davidpalma666/OE-PyBoard-tester-Fork/abstract remake Filipe @17122025.jpg

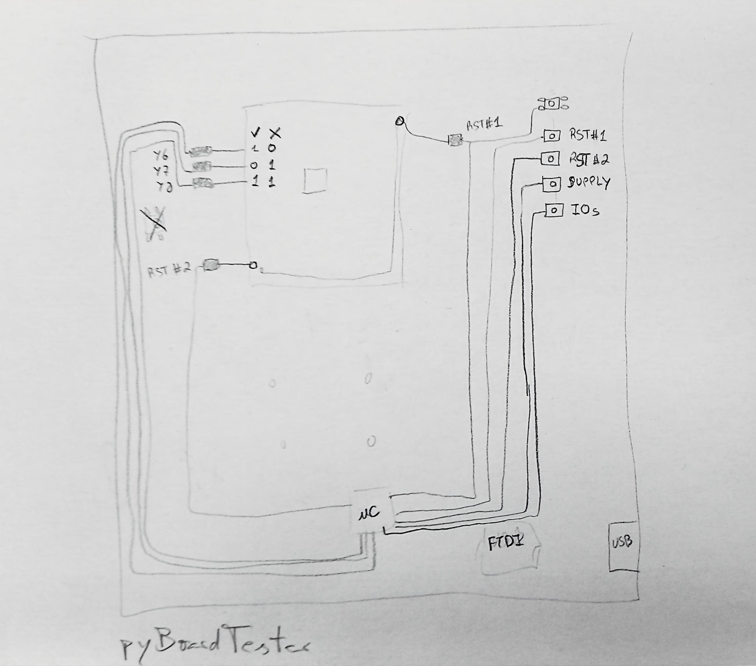
abstract remake Filipe @17122025.jpg
