davidpalma666/OE-PyBoard-tester-Fork/PCB/OE PyBoard tester FootprintLib/SW_SPST_TL3305B.step

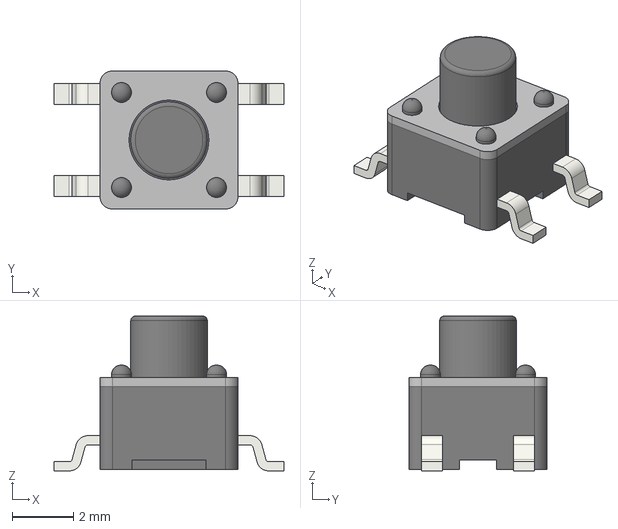
[picture p2: CAD file, 2026-01-06]
PCB/OE PyBoard tester FootprintLib/SW_SPST_TL3305B.step
7.50 x 4.50 x 5.05 mm
