davidpalma666/OE-PyBoard-tester-Fork/PCB/OE PyBoard tester FootprintLib/TSW-116-06-T-S.stp

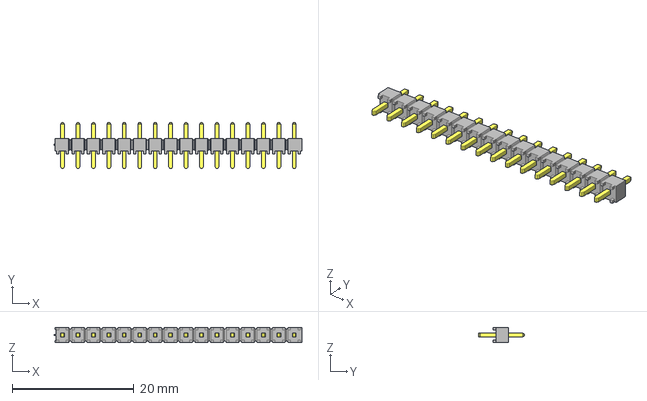
[picture p3: CAD file, 2026-01-06]
PCB/OE PyBoard tester FootprintLib/TSW-116-06-T-S.stp
40.8 x 7.62 x 2.54 mm
TSW-116-06-T-S_body
T-1S6-18-TSW-1-06-16-S
