davidpalma666/OE-PyBoard-tester-Fork/PCB/OE PyBoard tester FootprintLib/ECS-.327-12.5-17X-C-TR.step

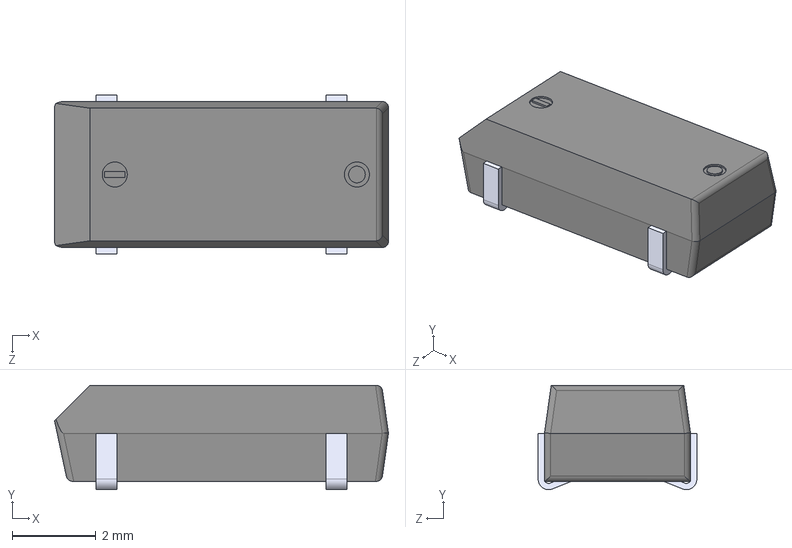
[picture p4: CAD file, 2026-01-06]
PCB/OE PyBoard tester FootprintLib/ECS-.327-12.5-17X-C-TR.step
8.00 x 2.50 x 3.80 mm
