davidpalma666/OE-PyBoard-tester-Fork/PCB/OE PyBoard tester FootprintLib/475710001.stp

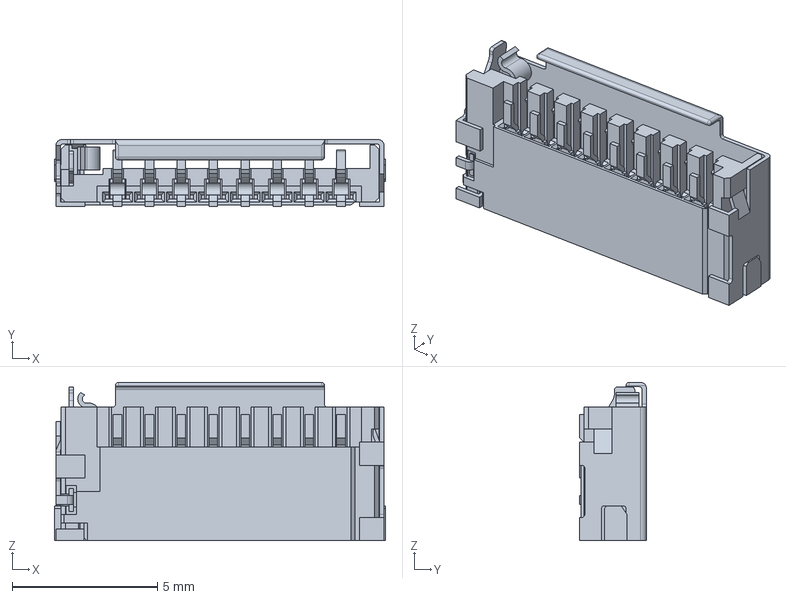
[picture p5: CAD file, 2026-01-06]
PCB/OE PyBoard tester FootprintLib/475710001.stp
11.4 x 2.30 x 5.45 mm
