davidpalma666/OE-PyBoard-tester-Fork/PCB/OE PyBoard tester.kicad_pcb

## KiCad design PCB/OE PyBoard tester.kicad_pcb (2026-01-22)

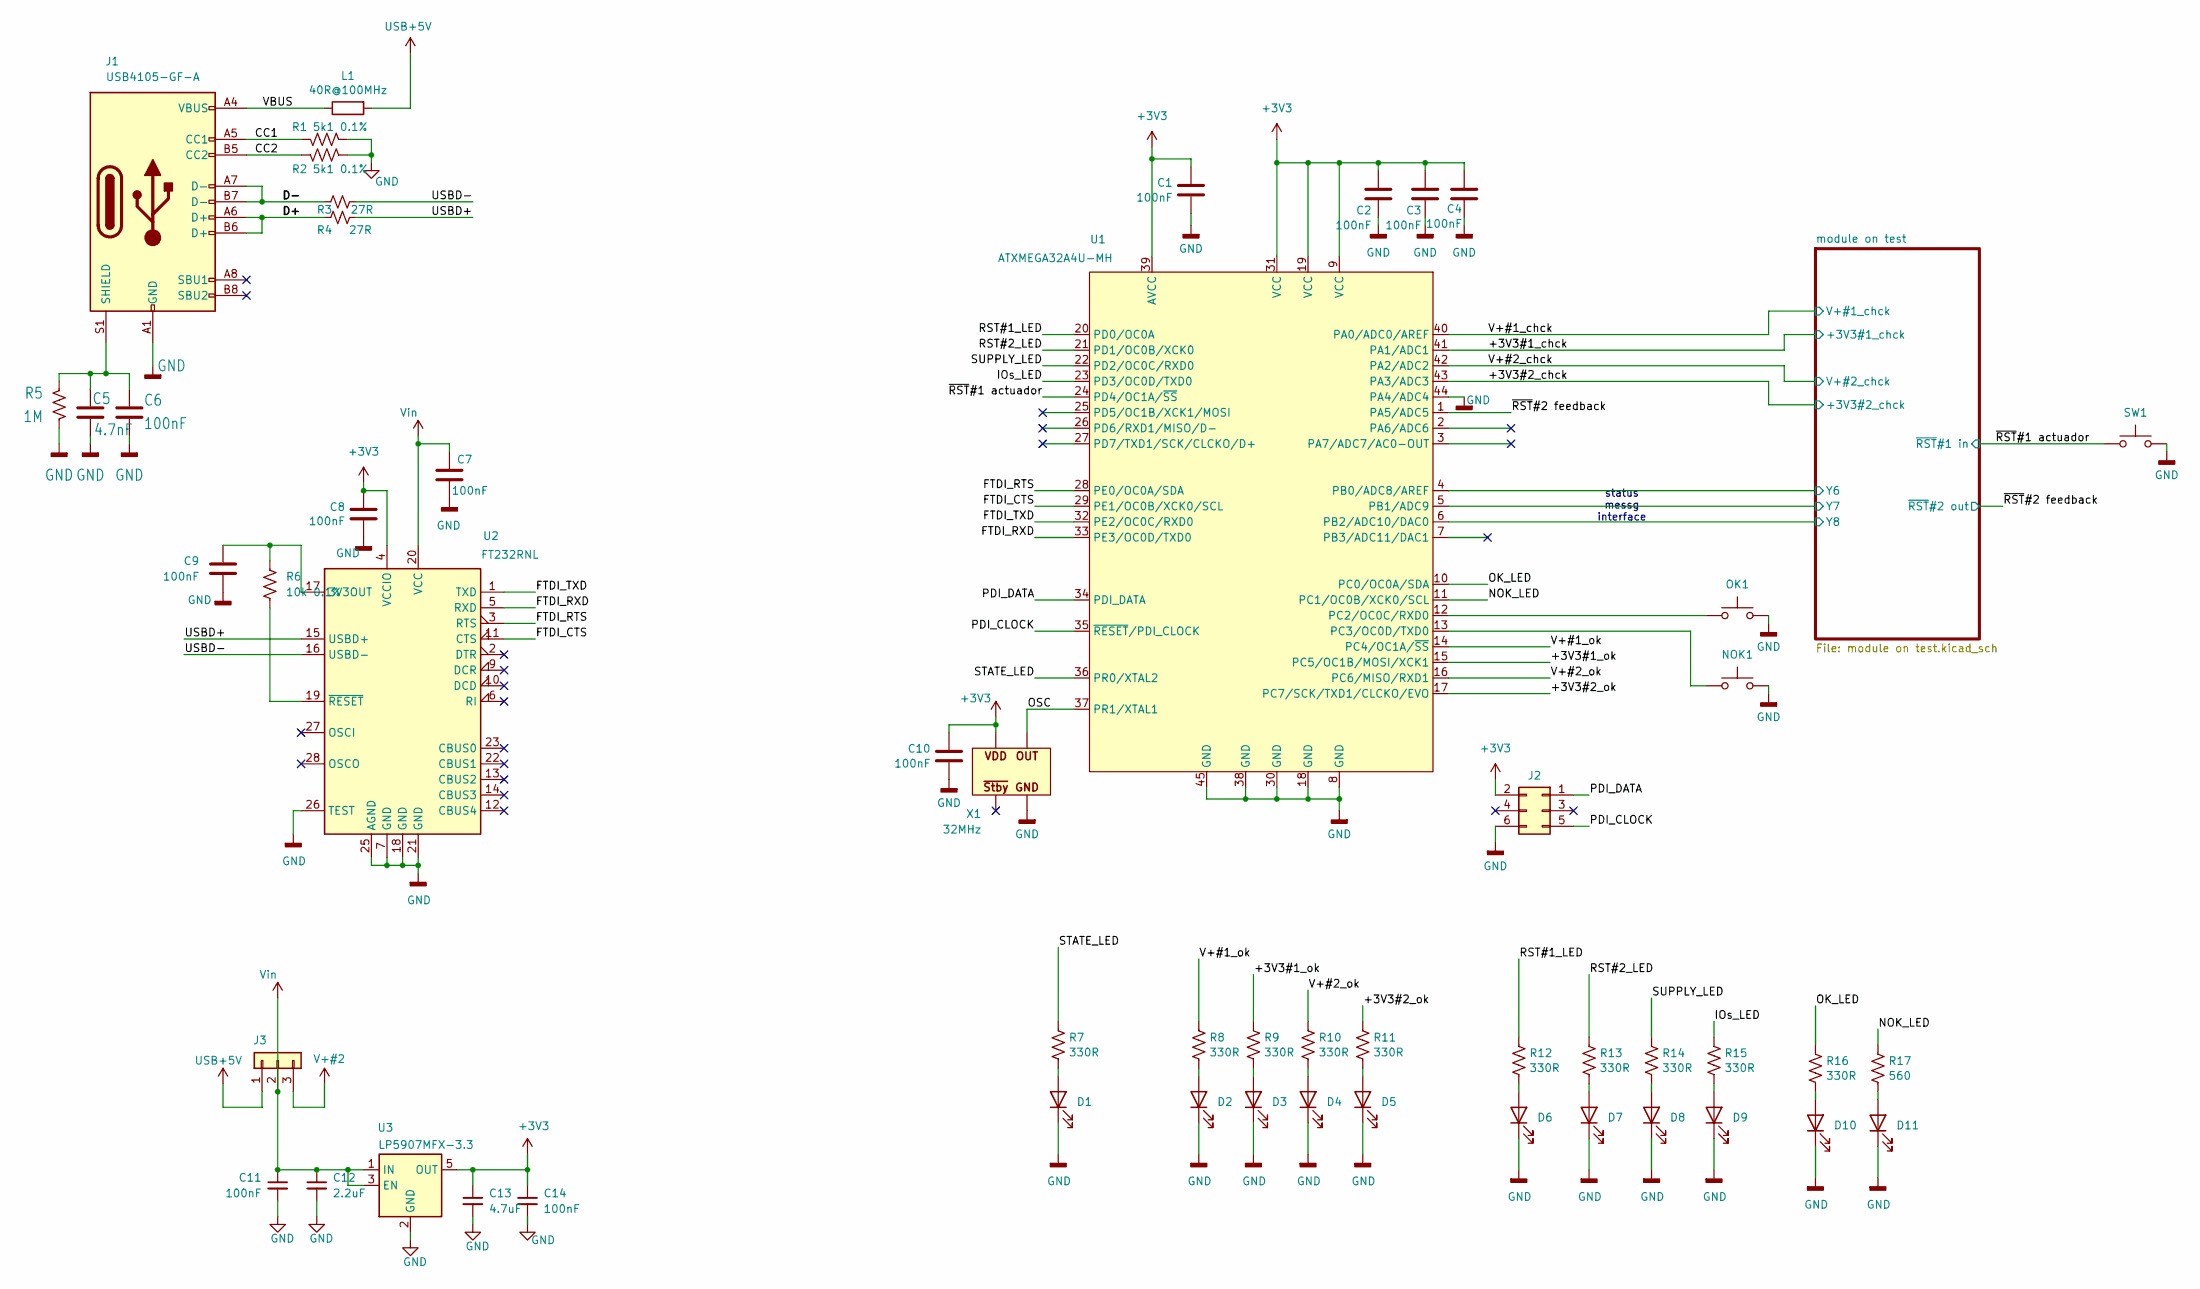
[picture p6: schematic OE PyBoard tester.kicad_sch]

Parts:
C1, C2, C3, C4, C6, C7, C8, C9, C10, C11, C14: 100nF; C_0402_1005Metric; MPN CGA2B3X7R1H104K050BB
C5: 4.7nF; C_0402_1005Metric; MPN 885012205084
C12: 2.2uF; C_0603_1608Metric; MPN GRM188R61E225KA12D
C13: 4.7uF; C_0603_1608Metric; MPN C1608X6S1C475K080AC
D1, D2, D3, D4, D5, D6, D7, D8, D9, D10: Green LED; LED_0603_1608Metric; MPN LTST-C191KGKT
D11: Red LED; LED_0603_1608Metric; MPN 5990010007F
J1: USB4105-GF-A; USB_C_Receptacle_GCT_USB4105-xx-A_16P_TopMnt_Horizontal; MPN USB4105-GF-A
J2: 6pin_hd; PinHeader_2x03_P2.54mm_Vertical; MPN 67996-206HLF
J3: 3pin_hd; SolderJumper-3_P1.3mm_Bridged12_RoundedPad1.0x1.5mm; MPN n.a.
L1: 40R@100MHz; R_0805_2012Metric; MPN MI0805K400R-10
NOK1: SW_SPST; SW_SPST_TL3305B; MPN TL3305BF260QG
OK1: SW_SPST; SW_SPST_TL3305B; MPN TL3305BF260QG
R1, R2: 5k1 0.1%; R_0402_1005Metric; MPN RT0402BRD075K1L
R3, R4: 27R; R_0402_1005Metric; MPN RMCF0402FT27R0
R5: 1M; R_0402_1005Metric; MPN CRCW04021M00FKED
R6: 10k 0.1%; R_0402_1005Metric; MPN CPF0402B10KE1
R7, R8, R9, R10, R11, R12, R13, R14, R15, R16: 330R; R_0402_1005Metric; MPN CRCW0402330RFKEDHP
R17: 560; R_0402_1005Metric; MPN CRCW0402560RFKED
SW1: SW_SPST; SW_SPST_TL3305B; MPN TL3305BF260QG
U1: ATXMEGA32A4U-MH; QFN-44-1EP_7x7mm_P0.5mm_EP5.2x5.2mm; MPN ATXMEGA32A4U-MHR
U2: FT232RNL; SSOP-28_5.3x10.2mm_P0.65mm; MPN FT232RNL-REEL
U3: LP5907MFX-3.3; SOT-23-5; MPN LP5907MFX-3.3/NOPB
X1: 32MHz; OSC; MPN DSC1001CI5-032.0000

Connections:
+3V3: C1.1, C2.1, C3.1, C4.1, C8.1, C10.1, C13.1, C14.1, J2.2, U1.9 (VCC), U1.19 (VCC), U1.31 (VCC), U1.39 (AVCC), U2.4 (VCCIO), U3.5 (OUT), X1.4 (VDD); also elsewhere on the board
/+3V3#1_chck: U1.41 (PA1/ADC1); also elsewhere on the board
/+3V3#1_ok: R9.2, U1.15 (PC5/OC1B/MOSI/XCK1)
/+3V3#2_chck: U1.43 (PA3/ADC3); also elsewhere on the board
/+3V3#2_ok: R11.2, U1.17 (PC7/SCK/TXD1/CLCKO/EVO)
/CC1: J1.A5 (CC1), R1.1
/CC2: J1.B5 (CC2), R2.1
/D+: J1.A6 (D+), J1.B6 (D+), R4.2
/D-: J1.A7 (D-), J1.B7 (D-), R3.2
/FTDI_CTS: U1.29 (PE1/OC0B/XCK0/SCL), U2.11 (CTS)
/FTDI_RTS: U1.28 (PE0/OC0A/SDA), U2.3 (RTS)
/FTDI_RXD: U1.33 (PE3/OC0D/TXD0), U2.5 (RXD)
/FTDI_TXD: U1.32 (PE2/OC0C/RXD0), U2.1 (TXD)
/IOs_LED: R15.2, U1.23 (PD3/OC0D/TXD0)
/NOK_LED: R17.2, U1.11 (PC1/OC0B/XCK0/SCL)
/OK_LED: R16.2, U1.10 (PC0/OC0A/SDA)
/OSC: U1.37 (PR1/XTAL1), X1.3 (OUT)
/PDI_CLOCK: J2.5, U1.35 (~RESET/PDI_CLOCK)
/PDI_DATA: J2.1, U1.34 (PDI_DATA)
/RST#1_LED: R12.2, U1.20 (PD0/OC0A)
/RST#2_LED: R13.2, U1.21 (PD1/OC0B/XCK0)
/STATE_LED: R7.2, U1.36 (PR0/XTAL2)
/SUPPLY_LED: R14.2, U1.22 (PD2/OC0C/RXD0)
/USBD+: R4.1, U2.15 (USBD+)
/USBD-: R3.1, U2.16 (USBD-)
/V+#1_chck: U1.40 (PA0/ADC0/AREF); also elsewhere on the board
/V+#1_ok: R8.2, U1.14 (PC4/OC1A/~SS)
/V+#2_chck: U1.42 (PA2/ADC2); also elsewhere on the board
/V+#2_ok: R10.2, U1.16 (PC6/MISO/RXD1)
/VBUS: J1.A4 (VBUS), J1.A9 (VBUS), J1.B4 (VBUS), J1.B9 (VBUS), L1.1
/module on test/PB10-Y9: U1.5 (PB1/ADC9); also elsewhere on the board
/module on test/PB11-Y10: U1.6 (PB2/ADC10/DAC0); also elsewhere on the board
/module on test/PB13-Y6: U1.4 (PB0/ADC8/AREF); also elsewhere on the board
/~RST#1 actuador: SW1.1, U1.24 (PD4/OC1A/~SS); also elsewhere on the board
/~RST#2 feedback: U1.1 (PA5/ADC5); also elsewhere on the board
GND: C1.2, C2.2, C3.2, C4.2, C5.2, C6.1, C7.2, C8.2, C9.1, C10.2, C11.2, C12.2, C13.2, C14.2, D1.1 (K), D2.1 (K), D3.1 (K), D4.1 (K), D5.1 (K), D6.1 (K), D7.1 (K), D8.1 (K), D9.1 (K), D10.1 (K), D11.1 (K), J1.A1 (GND), J1.A12 (GND), J1.B1 (GND), J1.B12 (GND), J2.6, NOK1.2, OK1.2, R1.2, R2.2, R5.1, SW1.2, U1.8 (GND), U1.18 (GND), U1.30 (GND), U1.38 (GND), U1.44 (PA4/ADC4), U1.45 (GND), U2.7 (GND), U2.18 (GND), U2.21 (GND), U2.25 (AGND), U2.26 (TEST), U3.2 (GND), X1.2 (GND); also elsewhere on the board
unnamed: D1.2 (A), R7.1
unnamed: D2.2 (A), R8.1
unnamed: D3.2 (A), R9.1
unnamed: D4.2 (A), R10.1
unnamed: D5.2 (A), R11.1
unnamed: D6.2 (A), R12.1
unnamed: D7.2 (A), R13.1
unnamed: D8.2 (A), R14.1
unnamed: D9.2 (A), R15.1
unnamed: D10.2 (A), R16.1
unnamed: D11.2 (A), R17.1
unnamed: C5.1, C6.2, J1.S1 (SHIELD), R5.2
unnamed: OK1.1, U1.12 (PC2/OC0C/RXD0)
unnamed: NOK1.1, U1.13 (PC3/OC0D/TXD0)
unnamed: C9.2, R6.1, U2.17 (3V3OUT)
unnamed: R6.2, U2.19 (~RESET)
USB+5V: J3.1, L1.2
V+#2: J3.3; also elsewhere on the board
Vin: C7.1, C11.1, C12.1, J3.2, U2.20 (VCC), U3.1 (IN), U3.3 (EN)

Notes on the sheet:
status messg interface

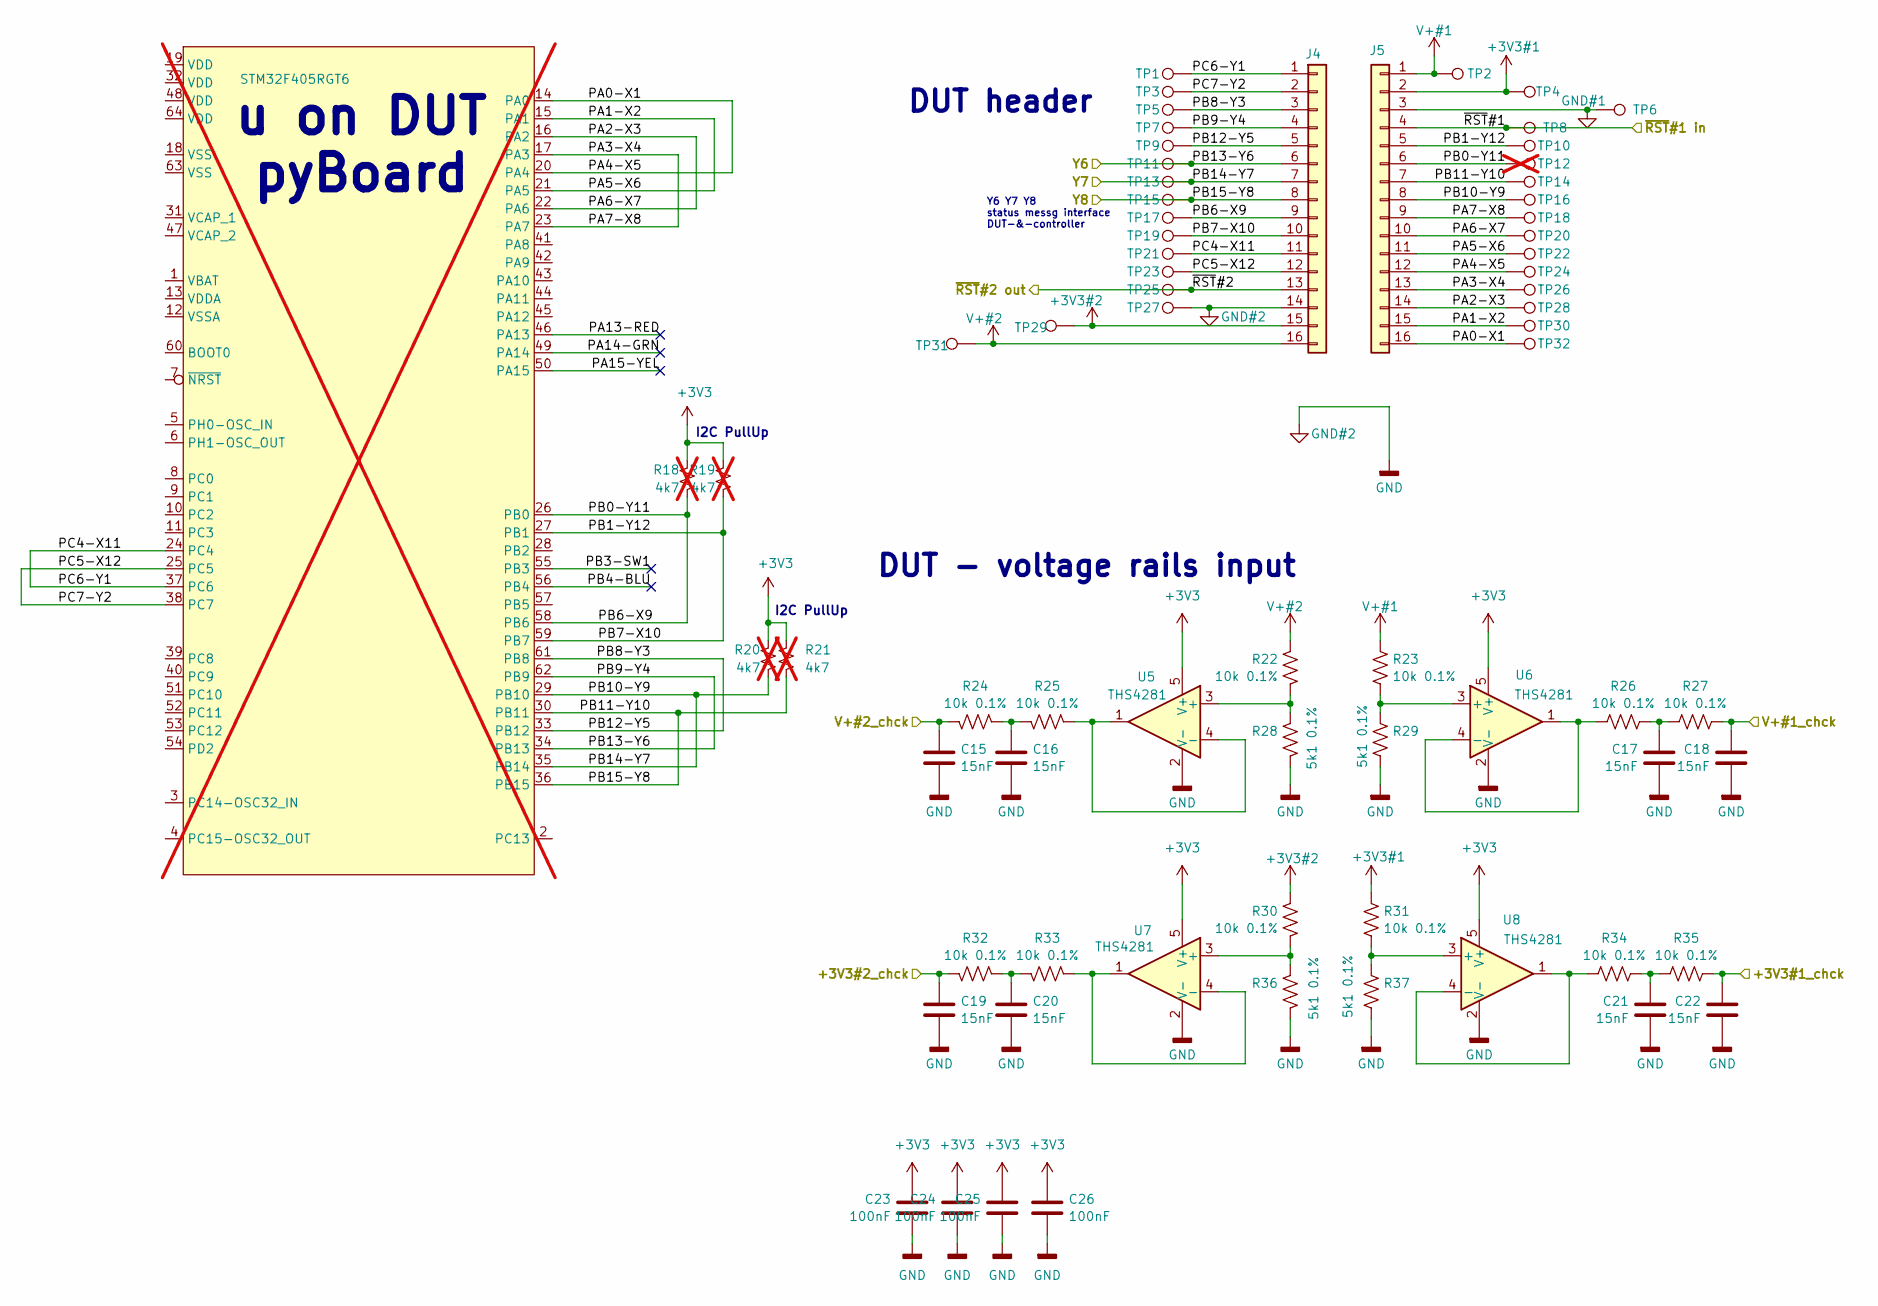
[picture p7: schematic module on test.kicad_sch]

Parts:
C15, C16, C17, C18, C19, C20, C21, C22: 15nF; C_0402_1005Metric_Pad0.74x0.62mm_HandSolder; MPN CGA2B3X7R1V153K050BB
C23, C24, C25, C26: 100nF; C_0402_1005Metric; MPN CGA2B3X7R1H104K050BB
J4, J5: Conn_01x08; PinHeader_1x16_P2.54mm_Vertical; MPN TSW-116-06-T-S
R18, R19, R20, R21: 4k7; R_0402_1005Metric; MPN ERJ-2RKF4701X; not fitted
R22, R23, R24, R25, R26, R27, R30, R31, R32, R33, R34, R35: 10k 0.1%; R_0402_1005Metric; MPN CPF0402B10KE1
R28, R29, R36, R37: 5k1 0.1%; R_0402_1005Metric; MPN RT0402BRD075K1L
TP1, TP2, TP3, TP4, TP5, TP7, TP8, TP9, TP10, TP11, TP13, TP14, TP15, TP16, TP17, TP18, TP19, TP20, TP21, TP22, TP23, TP24, TP25, TP26, TP28, TP29, TP30, TP31, TP32: TestPoint; TestPoint_Keystone_5015_Micro_Mini
TP6, TP27: TestPoint; TestPoint_Keystone_5000-5004_Miniature
TP12: TestPoint; TestPoint_Keystone_5015_Micro_Mini; not fitted
U4: STM32F405RGT6; LQFP-64_10x10mm_P0.5mm; MPN STM32F405RGT6; not fitted
U5, U6, U7, U8: THS4281; SOT-23-5; MPN THS4281DBVT

Connections:
+3V3: C23.1, C24.1, C25.1, C26.1, R18.1, R19.1, R20.1, R21.1, U5.5 (V+), U6.5 (V+), U7.5 (V+), U8.5 (V+); also elsewhere on the board
+3V3#1: J5.2, R31.2, TP4.1
+3V3#2: J4.15, R30.2, TP29.1
/+3V3#1_chck: C22.1, R35.2; also elsewhere on the board
/+3V3#2_chck: C19.1, R32.2; also elsewhere on the board
/V+#1_chck: C18.1, R27.2; also elsewhere on the board
/V+#2_chck: C15.1, R24.2; also elsewhere on the board
/module on test/PA0-X1: J5.12, J5.16, TP24.1, TP32.1, U4.14 (PA0), U4.20 (PA4)
/module on test/PA1-X2: J5.11, J5.15, TP22.1, TP30.1, U4.15 (PA1), U4.21 (PA5)
/module on test/PA2-X3: J5.10, J5.14, TP20.1, TP28.1, U4.16 (PA2), U4.22 (PA6)
/module on test/PA3-X4: J5.9, J5.13, TP18.1, TP26.1, U4.17 (PA3), U4.23 (PA7)
/module on test/PB0-Y11: J4.9, J5.6, R18.2, TP12.1, TP17.1, U4.26 (PB0), U4.58 (PB6)
/module on test/PB1-Y12: J4.10, J5.5, R19.2, TP10.1, TP19.1, U4.27 (PB1), U4.59 (PB7)
/module on test/PB10-Y9: J4.7, J5.8, R20.2, TP13.1, TP16.1, U4.29 (PB10), U4.35 (PB14); also elsewhere on the board
/module on test/PB11-Y10: J4.8, J5.7, R21.2, TP14.1, TP15.1, U4.30 (PB11), U4.36 (PB15); also elsewhere on the board
/module on test/PB12-Y5: J4.3, J4.5, TP5.1, TP9.1, U4.33 (PB12), U4.61 (PB8)
/module on test/PB13-Y6: J4.4, J4.6, TP7.1, TP11.1, U4.34 (PB13), U4.62 (PB9); also elsewhere on the board
/module on test/PC4-X11: J4.1, J4.11, TP1.1, TP21.1, U4.24 (PC4), U4.37 (PC6)
/module on test/PC5-X12: J4.2, J4.12, TP3.1, TP23.1, U4.25 (PC5), U4.38 (PC7)
/~RST#1 actuador: J5.4, TP8.1; also elsewhere on the board
/~RST#2 feedback: J4.13, TP25.1; also elsewhere on the board
GND: C15.2, C16.2, C17.2, C18.2, C19.2, C20.2, C21.2, C22.2, C23.2, C24.2, C25.2, C26.2, J4.14, R28.1, R29.1, R36.1, R37.1, TP27.1, U5.2 (V-), U6.2 (V-), U7.2 (V-), U8.2 (V-); also elsewhere on the board
GND#1: J5.3, TP6.1
unnamed: C16.1, R24.1, R25.2
unnamed: C17.1, R26.2, R27.1
unnamed: C20.1, R32.1, R33.2
unnamed: C21.1, R34.2, R35.1
unnamed: R22.1, R28.2, U5.3 (+)
unnamed: R25.1, U5.1, U5.4 (-)
unnamed: R23.1, R29.2, U6.3 (+)
unnamed: R26.1, U6.1, U6.4 (-)
unnamed: R30.1, R36.2, U7.3 (+)
unnamed: R33.1, U7.1, U7.4 (-)
unnamed: R31.1, R37.2, U8.3 (+)
unnamed: R34.1, U8.1, U8.4 (-)
V+#1: J5.1, R23.2, TP2.1
V+#2: J4.16, R22.2, TP31.1; also elsewhere on the board

Notes on the sheet:
DUT header
I2C PullUp
DUT - voltage rails input
Y6 Y7 Y8 status messg interface DUT-&-controller
u on DUT pyBoard

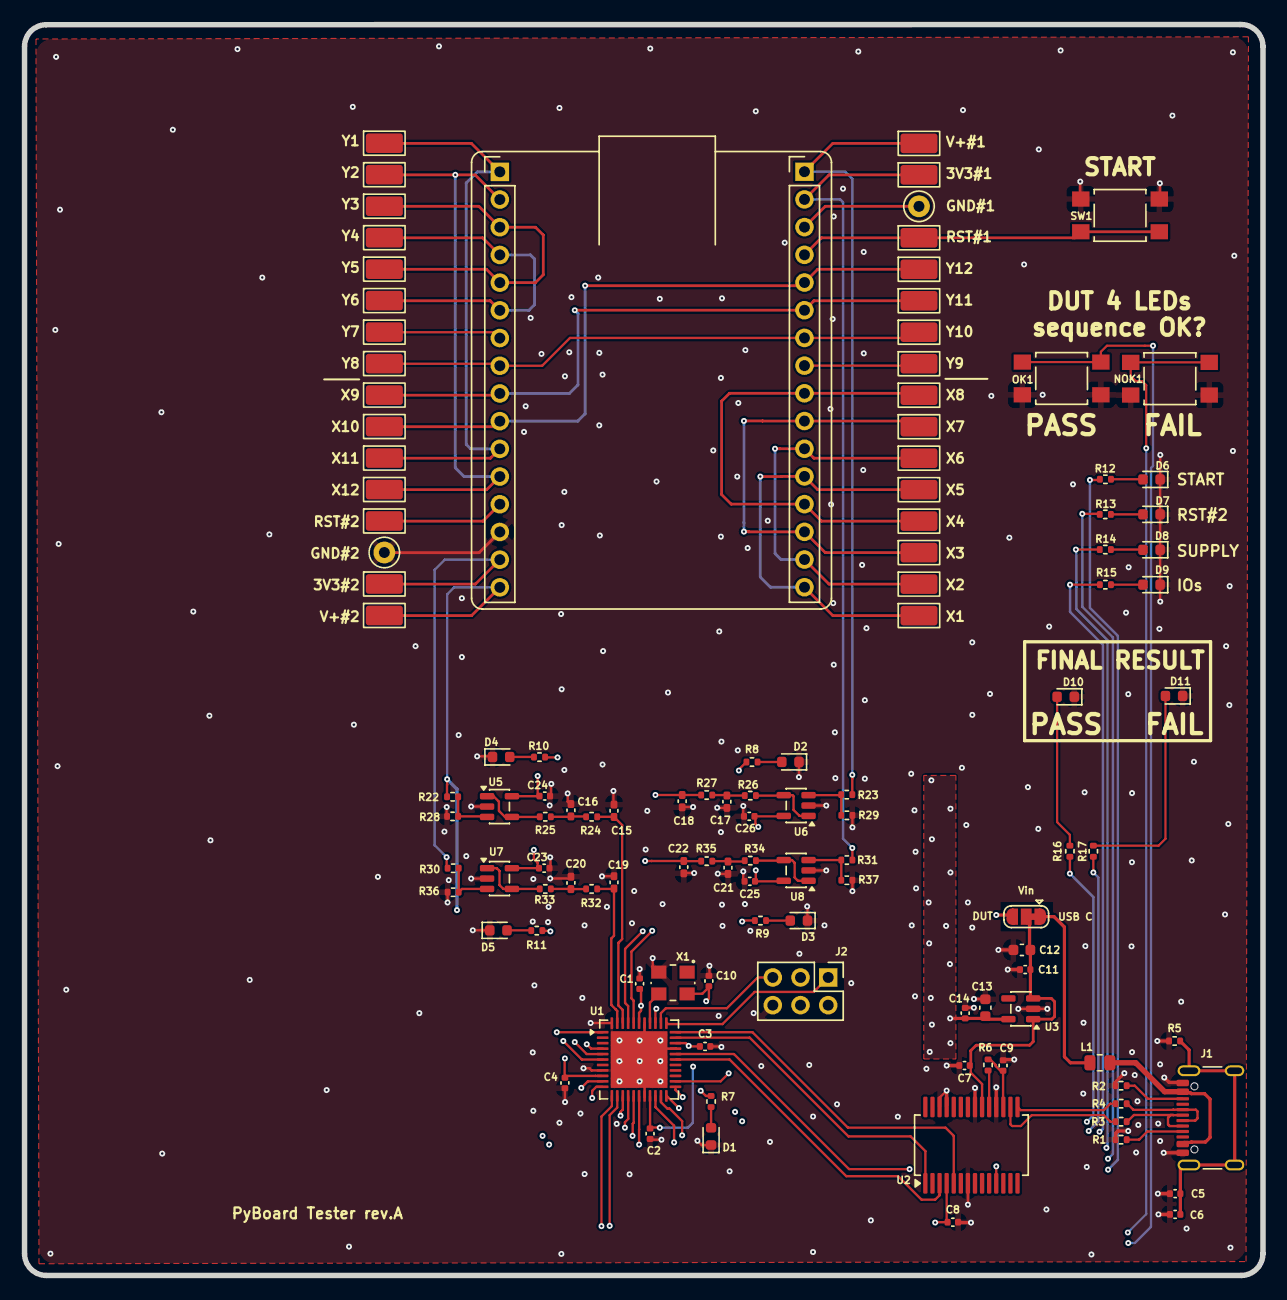
[picture p8: board OE PyBoard tester.kicad_pcb from above]

Board: 4 copper layers, 113.5 x 114.7 mm, 119 parts (0 on the bottom side), 80 nets.
