davidpalma666/OE-PyBoard-tester-Fork/PCB/PyBoardTester.kicad_pcb

## KiCad design PCB/PyBoardTester.kicad_pcb (2026-01-15)

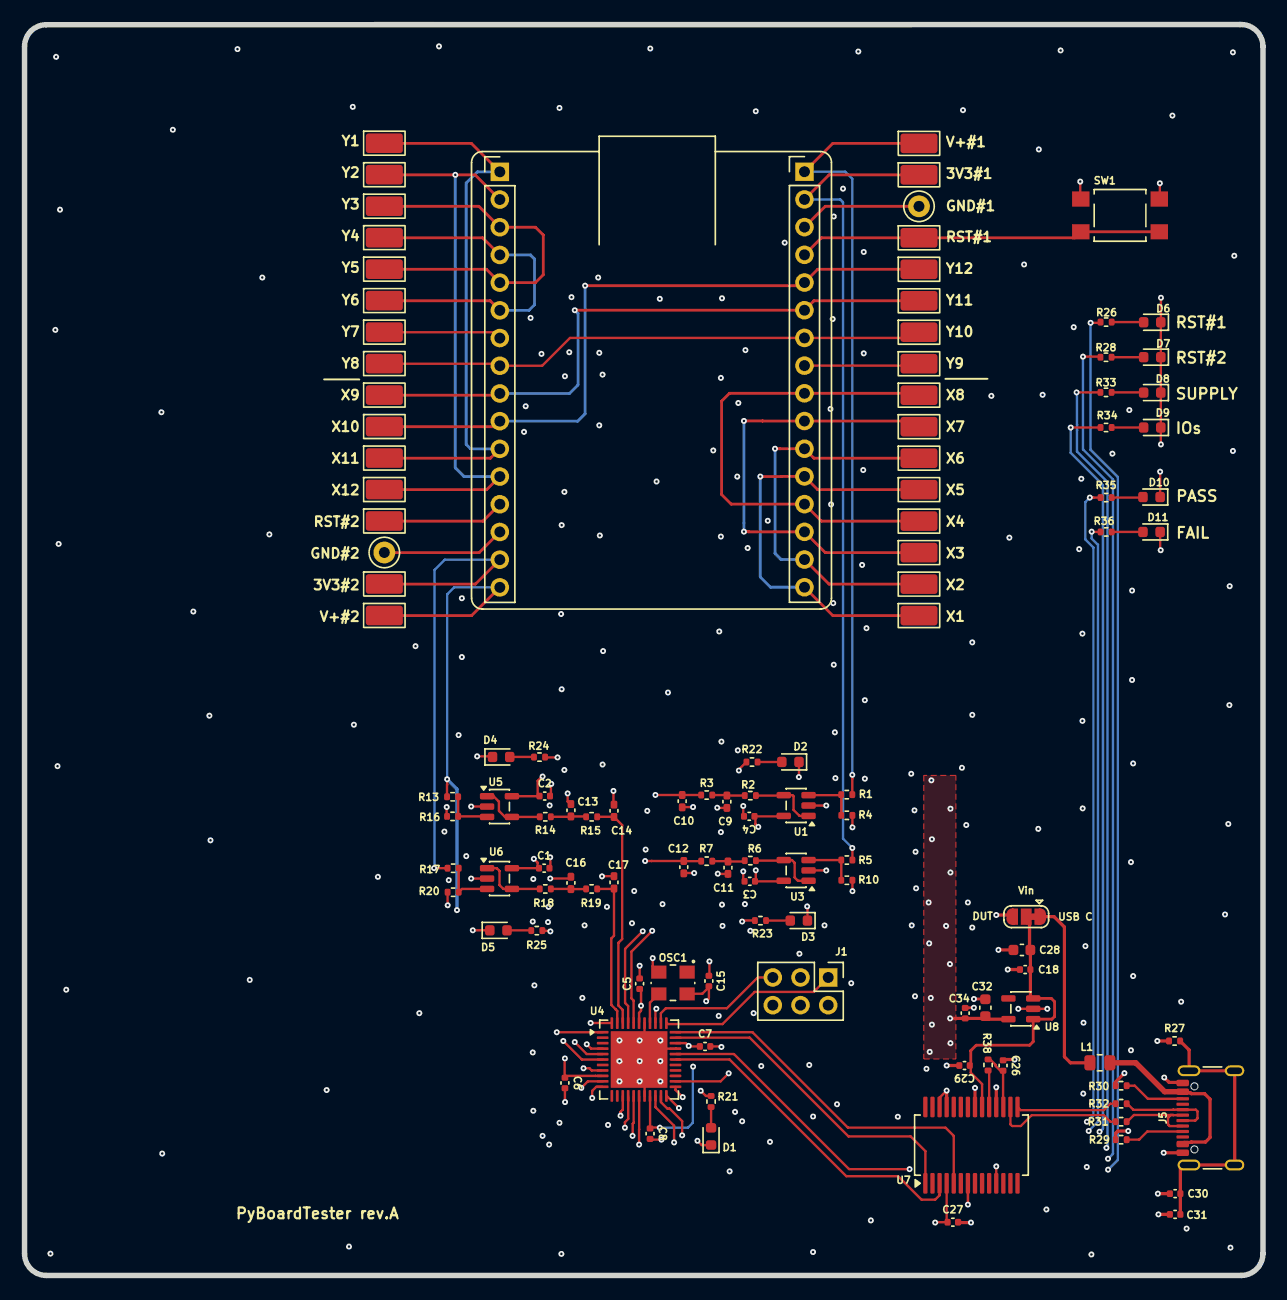
[picture p9: board PyBoardTester.kicad_pcb from above]

Board: 4 copper layers, 113.5 x 114.7 mm, 117 parts (0 on the bottom side), 78 nets.

Parts:
C1, C2, C3, C4, C5, C6, C7, C8, C15, C18, C26, C27, C29, C31, C34: 100nF; C_0402_1005Metric
C9, C10, C11, C12, C13, C14, C16, C17: 15nF; C_0402_1005Metric_Pad0.74x0.62mm_HandSolder
C28: 2.2uF; C_0603_1608Metric
C30: 4.7nF; C_0402_1005Metric
C32: 4.7uF; C_0603_1608Metric
D1, D2, D3, D4, D5, D6, D7, D8, D9, D10: Green LED; LED_0603_1608Metric
D11: Red LED; LED_0603_1608Metric
J1: 6pin_hd; PinHeader_2x03_P2.54mm_Vertical
J2, J3: Conn_01x08; PinHeader_1x16_P2.54mm_Vertical
J4: 3pin_hd; SolderJumper-3_P1.3mm_Bridged12_RoundedPad1.0x1.5mm
J5: USB4105-GF-A; USB_C_Receptacle_GCT_USB4105-xx-A_16P_TopMnt_Horizontal
L1: 40R@100MHz; R_0805_2012Metric
OSC1: 32MHz; OSC
R1, R2, R3, R5, R6, R7, R13, R14, R15, R17, R18, R19, R38: 10k; R_0402_1005Metric
R4, R10, R16, R20, R29, R30: 5k1; R_0402_1005Metric
R21, R22, R23, R24, R25, R26, R28, R33, R34, R35: 330R; R_0402_1005Metric
R27: 1M; R_0402_1005Metric
R31, R32: 27R; R_0402_1005Metric
R36: 560; R_0402_1005Metric
SW1: SW_SPST; SW_SPST_TL3305B
TP1, TP2, TP3, TP4, TP5, TP7, TP8, TP9, TP10, TP11, TP12, TP13, TP14, TP15, TP16, TP17, TP18, TP19, TP20, TP21, TP22, TP23, TP24, TP25, TP26, TP28, TP29, TP30, TP31, TP32: TestPoint; TestPoint_Keystone_5015_Micro_Mini
TP6, TP27: TestPoint; TestPoint_Keystone_5000-5004_Miniature
U1, U3, U5, U6: THS4281; SOT-23-5
U4: ATXMEGA32A4U-MH; QFN-44-1EP_7x7mm_P0.5mm_EP5.2x5.2mm
U7: FT232RNL; SSOP-28_5.3x10.2mm_P0.65mm
U8: LP5907MFX-3.3; SOT-23-5

Connections:
+3V3: C1.1, C2.1, C3.1, C4.1, C5.1, C6.1, C7.1, C8.1, C15.1, C27.1, C32.1, C34.1, J1.2, OSC1.4 (VDD), U1.5 (V+), U3.5 (V+), U4.9 (VCC), U4.19 (VCC), U4.31 (VCC), U4.39 (AVCC), U5.5 (V+), U6.5 (V+), U7.4 (VCCIO), U8.5 (OUT)
+3V3#1: J3.2, R5.2, TP4.1
+3V3#2: J2.15, R17.2, TP29.1
/+3V3#1_chck: C12.1, R7.2, U4.41 (PA1/ADC1)
/+3V3#1_ok: R23.2, U4.15 (PC5/OC1B/MOSI/XCK1)
/+3V3#2_chck: C17.1, R19.2, U4.43 (PA3/ADC3)
/+3V3#2_ok: R25.2, U4.17 (PC7/SCK/TXD1/CLCKO/EVO)
/CC1: J5.A5 (CC1), R29.1
/CC2: J5.B5 (CC2), R30.1
/D+: J5.A6 (D+), J5.B6 (D+), R32.2
/D-: J5.A7 (D-), J5.B7 (D-), R31.2
/FTDI_CTS: U4.29 (PE1/OC0B/XCK0/SCL), U7.11 (CTS)
/FTDI_RTS: U4.28 (PE0/OC0A/SDA), U7.3 (RTS)
/FTDI_RXD: U4.33 (PE3/OC0D/TXD0), U7.5 (RXD)
/FTDI_TXD: U4.32 (PE2/OC0C/RXD0), U7.1 (TXD)
/IOs_LED: R34.2, U4.23 (PD3/OC0D/TXD0)
/NOK_LED: R36.2, U4.11 (PC1/OC0B/XCK0/SCL)
/OK_LED: R35.2, U4.10 (PC0/OC0A/SDA)
/OSC: OSC1.3 (OUT), U4.37 (PR1/XTAL1)
/PDI_CLOCK: J1.5, U4.35 (~RESET/PDI_CLOCK)
/PDI_DATA: J1.1, U4.34 (PDI_DATA)
/RST#1_LED: R26.2, U4.20 (PD0/OC0A)
/RST#2_LED: R28.2, U4.21 (PD1/OC0B/XCK0)
/STATE_LED: R21.2, U4.36 (PR0/XTAL2)
/SUPPLY_LED: R33.2, U4.22 (PD2/OC0C/RXD0)
/USBD+: R32.1, U7.15 (USBD+)
/USBD-: R31.1, U7.16 (USBD-)
/V+#1_chck: C10.1, R3.2, U4.40 (PA0/ADC0/AREF)
/V+#1_ok: R22.2, U4.14 (PC4/OC1A/~SS)
/V+#2_chck: C14.1, R15.2, U4.42 (PA2/ADC2)
/V+#2_ok: R24.2, U4.16 (PC6/MISO/RXD1)
/VBUS: J5.A4 (VBUS), J5.A9 (VBUS), J5.B4 (VBUS), J5.B9 (VBUS), L1.1
/module on test/PA0-X1: J3.12, J3.16, TP24.1, TP32.1
/module on test/PA1-X2: J3.11, J3.15, TP22.1, TP30.1
/module on test/PA2-X3: J3.10, J3.14, TP20.1, TP28.1
/module on test/PA3-X4: J3.9, J3.13, TP18.1, TP26.1
/module on test/PB0-Y11: J2.9, J3.6, TP12.1, TP17.1
/module on test/PB1-Y12: J2.10, J3.5, TP10.1, TP19.1
/module on test/PB10-Y9: J2.7, J3.8, TP13.1, TP16.1, U4.5 (PB1/ADC9)
/module on test/PB11-Y10: J2.8, J3.7, TP14.1, TP15.1, U4.6 (PB2/ADC10/DAC0)
/module on test/PB12-Y5: J2.3, J2.5, TP5.1, TP9.1
/module on test/PB13-Y6: J2.4, J2.6, TP7.1, TP11.1, U4.4 (PB0/ADC8/AREF)
/module on test/PC4-X11: J2.1, J2.11, TP1.1, TP21.1
/module on test/PC5-X12: J2.2, J2.12, TP3.1, TP23.1
/~RST#1 actuador: J3.4, SW1.1, TP8.1, U4.24 (PD4/OC1A/~SS)
/~RST#2 feedback: J2.13, TP25.1, U4.1 (PA5/ADC5)
GND: C1.2, C2.2, C3.2, C4.2, C5.2, C6.2, C7.2, C8.2, C9.2, C10.2, C11.2, C12.2, C13.2, C14.2, C15.2, C16.2, C17.2, C18.2, C26.1, C27.2, C28.2, C29.2, C30.2, C31.1, C32.2, C34.2, D1.1 (K), D2.1 (K), D3.1 (K), D4.1 (K), D5.1 (K), D6.1 (K), D7.1 (K), D8.1 (K), D9.1 (K), D10.1 (K), D11.1 (K), J1.6, J2.14, J5.A1 (GND), J5.A12 (GND), J5.B1 (GND), J5.B12 (GND), OSC1.2 (GND), R4.1, R10.1, R16.1, R20.1, R27.1, R29.2, R30.2, SW1.2, TP27.1, U1.2 (V-), U3.2 (V-), U4.8 (GND), U4.18 (GND), U4.30 (GND), U4.38 (GND), U4.44 (PA4/ADC4), U4.45 (GND), U5.2 (V-), U6.2 (V-), U7.7 (GND), U7.18 (GND), U7.21 (GND), U7.25 (AGND), U7.26 (TEST), U8.2 (GND)
GND#1: J3.3, TP6.1
unnamed: C9.1, R2.2, R3.1
unnamed: C11.1, R6.2, R7.1
unnamed: C13.1, R14.2, R15.1
unnamed: C16.1, R18.2, R19.1
unnamed: D1.2 (A), R21.1
unnamed: D2.2 (A), R22.1
unnamed: D3.2 (A), R23.1
unnamed: D4.2 (A), R24.1
unnamed: D5.2 (A), R25.1
unnamed: D6.2 (A), R26.1
unnamed: D7.2 (A), R28.1
unnamed: D8.2 (A), R33.1
unnamed: D9.2 (A), R34.1
unnamed: D10.2 (A), R35.1
unnamed: D11.2 (A), R36.1
unnamed: C30.1, C31.2, J5.S1 (SHIELD), R27.2
unnamed: R1.1, R4.2, U1.3 (+)
unnamed: R2.1, U1.1, U1.4 (-)
unnamed: R5.1, R10.2, U3.3 (+)
unnamed: R6.1, U3.1, U3.4 (-)
unnamed: R13.1, R16.2, U5.3 (+)
unnamed: R14.1, U5.1, U5.4 (-)
unnamed: R17.1, R20.2, U6.3 (+)
unnamed: R18.1, U6.1, U6.4 (-)
unnamed: C26.2, R38.1, U7.17 (3V3OUT)
unnamed: R38.2, U7.19 (~RESET)
USB+5V: J4.1, L1.2
V+#1: J3.1, R1.2, TP2.1
V+#2: J2.16, J4.3, R13.2, TP31.1
Vin: C18.1, C28.1, C29.1, J4.2, U7.20 (VCC), U8.1 (IN), U8.3 (EN)
