davidpalma666/OE-PyBoard-tester-Fork/(commit log)

2026-01-06 1st commit to 1st review
    [475710001.stp, ECS-.327-12.5-17X-C-TR.step, PyBoardTester BOM.csv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]
2026-01-09 modificado power-jumper
    - passou a ser solder-jumper
    - default: ligado a USB-Power
    [PyBoard Tester BOM.csv, PyBoardTester BOM.csv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]
2026-01-15 após revisão do Filipe
    - adicionados LEDs PASS & FAIL para sinalizar fim teste
    - modificadasa Designators de LEDs para estar coerente na BOM
    - unidos pares de IOs do pyBoard q faltavam
    - reimensionado divisor resistivo para ADC-In
    [PyBoard Tester BOM.csv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]
2026-01-20 modificado nome projecto - OE PyBoard tester
    OE PyBoard tester
    - feita nova anotação para componentes ficarem com Referências sem jumps
    - novo nome às Symbol & Footprint Libraries
    - optimizadas link de componentes & footprints às novas Libraries
    - retirado campo 'values' de Fab. Layer
    - gerados novos ficheiros de produção: Gerbers & Drills & P&P & .d356 & BOM
    [475710001.stp, ECS-.327-12.5-17X-C-TR.step, OE PyBoard tester BOM.csv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]
2026-01-20 corrigidos ficheiros de produção
    - criados novos Gerbers & Drills em função da refª Drill/place Origin imposta - canto inferior esqº da PCB; Não a refª absoluta por default
    [OE PyBoard tester-B_Cu.gbr, OE PyBoard tester-B_Fab.gbr, OE PyBoard tester-B_Mask.gbr, OE PyBoard tester-B_Paste.gbr, OE PyBoard tester-B_Silkscreen.gbr, OE PyBoard tester-Edge_Cuts.gbr, OE PyBoard tester-F_Cu.gbr, OE PyBoard tester-F_Fab.gbr]
2026-01-22 synchronizing with main branch
    [OE PyBoard tester BOM.csv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]
