davidpalma666/OE-PyBoard-tester-Fork/(notices)

Notices in the files:
PCB/OE PyBoard tester FootprintLib/SW_SPST_TL3305B.step:
Copyright (C) 2025, KiCAD
This work is licensed under the
[Creative Commons CC-BY-SA 4.0 License](https://creativecommons.org/licenses/by-sa/4.0/legalcode),
with the following exception:
project files under this or any other license agreement. However, if you wish to distribute
PCB/OE PyBoard tester FootprintLib/TSW-116-06-T-S.stp:
author */ ('License CC BY-ND 4.0'),
